1000mohand/Power-Monitor-Project/docs/Design.pdf

# هاى

# ßb¨aõaŒg

# دة كل اللى أنا أعرفه حالياً عن المشروع

فكرة المشروع مبنية على 3 حجات .1 لازم إننا نعرف الجهاز بيسحب كام أمبير عشان نعرف معدل إستخدام الطاقة خلال الشهر. لازم نعرف الجهاز شغال إمتى و مقفول إمتى و إمتى الإستهلاك بيزيد و إمتى الإستهلاك بيكون غير طبيعى. .2 يبقى فيه تحكم ذكى فى الجهاز يتقفل عن بعد, يتفح عن بعد, يقفل تلقائى فى حالة إستهلاك غير طبيعى. .3 الــESB و دة الميكروكنترولر اللى هيعمل الحسابات كلها و تتحكم فيه عن طريق الــWiFi.

الجزئ اللى أنا شغال عليه هو جزء قراية التيار و دة كل االى أنا وصلتله فى الجزء دة.

## 1 قراءة التيار

بص يا سيدى ديه الدايرةالكهربية اللى أنا كنت بفكر فيها بدل ما نشترى Sensor Current بــ٥٠جم. ممكن إننا نشيله و نحط حاجة بسيطة رخيصة بحيث إن الدايرةكلها ما تزيدش عن ٣٠جم. دةغير إنك حتى لو حطيت Sensor Current بــ٥٠جم. لسة هاتحتاج Amplifier Operational عشان تعرف تكبر الفروق الصغيرة اللى بتطلع من الــSensor. و فوق كل دة بعض أنواع الــSensor Current بيحتاج يتعاير محتاج أنه يتقارن بجهد مبدأى عشان تاخد منه قريات.

### 1 .1 الدايرة

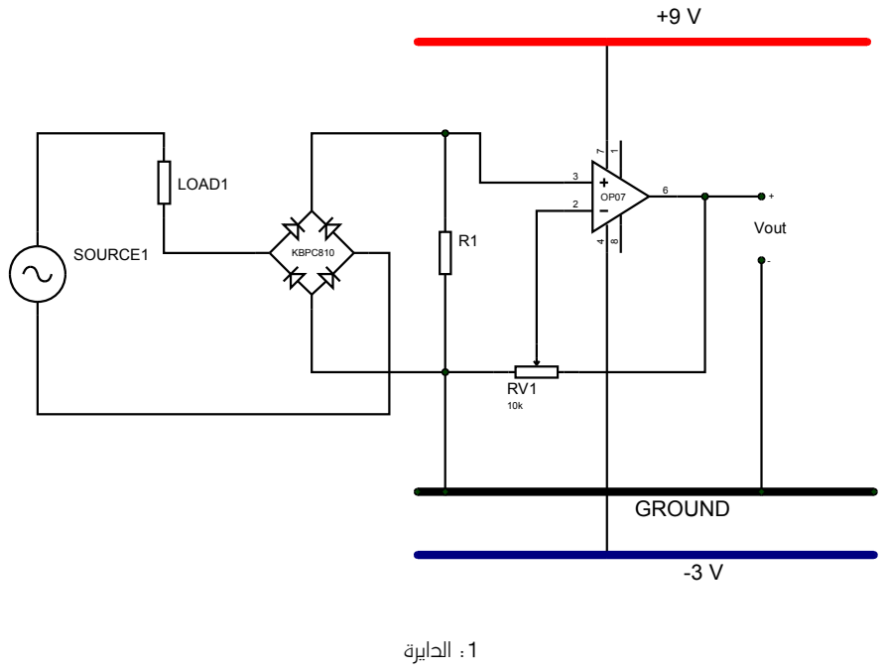
[picture p2: figure]
Vout; GROUND; SOURCE1; KBPC810; LOAD1; :1 الدايرة

بص يا سيدى:
ً أولا الــLOAD اللى انت شايفه هو والــSOURCE: دول بيمثله أى حاجة شغال (تكيف، عسالة، ماتور، اى حاجة...) و المتوصلة بالفيشة (اللى هى الــSOURCE طبعا).
ثانياً الحتة ديه ظريفة شوية، دة Rectifier شغلته أنه بيوحد إتجاه التيار اللى داخل على المقاومة الــ(Ω0.1(، و خلى بالك دة بيوحد التيار اللى داخل للمقاومة بس يعنى التيار و الجهد متغيرين عادى على الأحمال. ثالثاً هيييييـــــــح، التيار أياًكان إتجاهه على الــLOAD هايبفضل فى نفسالإتجاهعلى الــΩ،0.1 و دةعشان الــAMP OP يقرأ الڤولت اللى على المقاومة دايماَ فى نفس الإتجاه، الڤولت اللى على المقاومة بيبقا صغير و لذلك الــAMP OP بيكبره بشكل مناسب، ممكن إحنا نستغل دة بقا براحتنا بالتغير فى الريوستات 1RV بحيث إننا نظبط الڤولت بشكل يناسب الأردوينو أو الــESB. رابعاً مابين كل الأنواع بتاعة الــAmplifier Operational إحنا لازم نختار نوع يتعامل مع الڤولت الصغير بطريقة مناسبة. هتلاقى معظم الــAmplifiers Operational فيهم الــVolatge Offset¹ حوالى mV10–5 و دة كتير طبعا. النوع 07OP بقا دة الــOffset بتاعه
بيتقاس الــµV عشان كدة هو مناسب لينا. خامساً و أخيراً وديه بقا إسمها غباوة. بس دة اللى أنا عملته، النقط اللى متوصلة بالارضى كلها node واحدة هتبقى متوصلة بالأردوينو هنا بقى هتلاقى بعض متشددين الــsafety هايقولوا لو حصل fault ممكن يحصل مشاكل بس مصر كلها عايشة أهى قدامك و بقينا ١٠٠
مليون أو أكتر زى ما أنت شايف.☺ كان المفروض يبقا فيه Transformer Isolation ً مثلا أو أى حاجة ممكن تعمل Isolation بين الدايرتين(الــV220 AC و الــV12 DC (على سبيل المثال لو المقاومة Ω0.1 1R خرجت من الدايرة لأاى سبب أو أتحرقت الجهد اللى عليها

1الــVoltage Offset هو عبارة عن إزاحة صغيرة عن قيمة الجهد الداخل اللى بيكون عندها خرج الــ AMP OP V.0 شرحها على الموقع دة. (https://toshiba.semicon-storage.com/ap-en/semiconductor/knowledge/faq/linear_opamp/what-is-the-input-offset-voltage-of-an-op-amp.html)

هيبقى كبير جدا و أكيد هيبوظ الــAmplifier عشان كدة الدايرة ديه عايزة حرص كويس، وطالما إحنا إتعاملنا مع الدايرة كلها بحرص مش هيحص حاجة بإذن الله.

### 2 .1 حسبة الــGain

اللڤولت اللى على المقاومة 1R Ω1 صغير بيبقا بتاع V.1 اللڤولت دة مش مناسب أنه يتقرى على الــESB أو الأردوينو. الــAmplifier المفروض أنه يكبر الڤولت اللى على المقاومة 1R Ω1 عشان نعرف نحسب الــGain الصح بتاع الــAmplifier من الدايرة ممكن نتخيل إن الريوستات 1RV عبارة عن مقاومتين 2R 1,R.

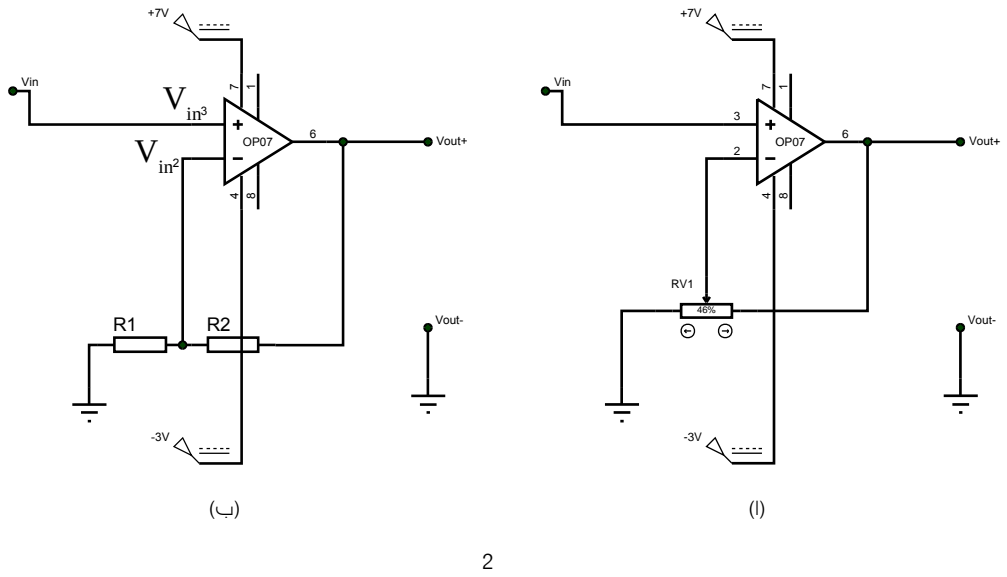
[picture p3: figure]
Vout-; Vin; Vout+

فى حالة إن الــAmplifier مثالى هيبقى 2Vin = 3Vin وعندنا

Vin² = Vout ×

R1
R1 + R2
يبقى

Vin³ = Vout ×

R1
R1 + R2
يعنى

Vout = Vin³ ×

R1 + R2
R1

= Vin ×

R1 + R2
R1

(1)

R1
يبقى إحنا ممكن نحدد قيمة الــgain بتاعنا عن طريق النسبة بين 2R1+R الــ07OP بيكبر من غير دايرة قيمة ضخمة جدا حوالى ٢٠٠ ألف مرة ضعف الجهد الداخل عشان كدة ممكن نعتبره قريب من أنه يكون مثالى، وعموما معظم أنواع الــAmplifier ليها معامل تكبير ضخم هو أنا جيبت الكلام دة من مكانين: الموقع دة (https://www.electronics-tutorials.ws/opamp/opamp_3.html) و الكتاب دة
المطلوب | الجزء | فيها | نسخة | هتلاقى | Behzad Razavi, Fundamentals of Microelectronics, Second Edition. page 357~359
مع الحاجة

### 3 .1 حساب نسبة التكبير من تيار الأحمال

إذا كانت مقاومة الأحمال هى RLOAD و الجهد الفعال (Volts 220 = VRMS (أى أن (Volts 311 ≈ Va = Vpeak(. يجب ظبط نسة التكبير لتحمل أقصى تيار لحظى أى (Va (بحيث عند هذا التيار يتولد أعلى جهد ممكن على دخل الــESB. أعلى جهد عند أعلى تيار يؤدى الى أعلى

دقة ممكنة. يكون الجهد المطبق على الأحمال أقل من VRMS بــ2 او 3 ڤولت نتيجة لوجود الــRectifier.

VLOAD = Va − Vdrop
| {z }

3 Volts
تضاف المقاومة Rsensor على التوالى مع الاحمال لقياس التيار. يمكن حساب التيار كالآتى

ILOAD =

Va − Vdrop

RLOAD + Rsensor
الجهد المتولد على المقاومة Rsensor هو الدخل للــAmplifier) Vsensor = Vin(. يجب أن يتم تكبيره ليصل الى أقصى جهد من خرج الــAmpilifer عند مرور أعلى تيار كالآتى:

Vout = Ga · Vin = Ga · ILOADRsensor

حيث Ga هو معامل التكبير. وإذا كان أقصى جهد لخرج الــAmplifier هو max Vout فإن:

Ga =

Vout

Vin

=

Vout max

Vsensor

=

Vout max

ILOADRsensor
من المعادلة 2 .1
R1 + R2
R1

= Ga

R1
R1 + R2

=

ILOADRsensor

Vout max

(2)

## 2 توزيعة الجهود و التغذية

عشاان نعرف نشغل الأجهز كل جهاز محتاج جهود مختلفة. .1 الــAmplifier محتاج جهد من V-3 لـV+9 عشان يشتغل. .2 الــ32ESP محتاجة V5 أو V.3.3 .3 طبعا الأرضى جهده V.0
هنستخدم طريقة بسيطة: أعلى جهد فى الدايرة هو الــV9 و أقل جهد هو V.-3 الفرق ما بينهم هو V.12 مش مهم حاجة فى الــsupply اللى هنستخدمه غير أنه يطلع فرق فى الجهود زى اللى إحنا عاوزينها. بمعنى إن لو الــsupply ً مثلا بيطلع V12 هيبقى أقل جهد فى الدايرة (الــV-3 (هو السالب بتاع الــsupply و الموجب هو الــV.9 كدة مظبوط الفرق بين أعلى جهد و أقل جهد فى الدايرة هو V.12 الجزئية اللى ّ بتلفف الدماغ الــGround فين؟ الــGround أعلى من الــV-3 بــV3 شيئ منطقى! الفكرة كلها أن الــGround دة نقطة فى الدايرة جهدها
ً | مفروض أنه بصفر عشان تقارن بقيت الجهود التانية بالنسبة ليه مش لأنه جهده فعلا بصفر. المهم دايما فى الدايرة عندك هو فرق الجهود. مثلا
فى الشكل 3 كل فروق الجهود ديه واحدة و كلهم نفس توزيعة الجهود و مناسبين لتشغيل الدايرة.

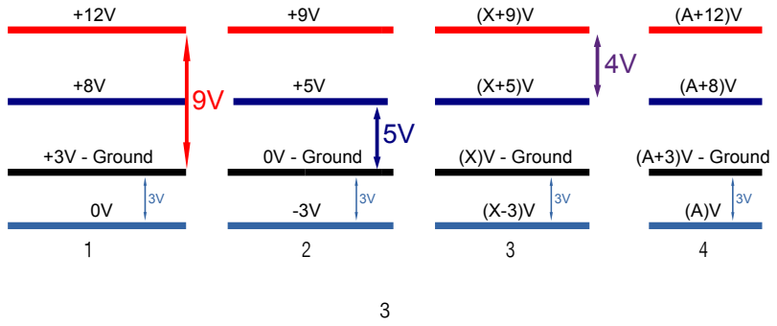
[picture p4: figure]
0V - Ground; (A+3)V - Ground; (X)V - Ground; +3V - Ground

طيب إحنا عرفنا نطلع أكبر جهد و أصغر جهد لكن الجهو اللى فى النصبتطلع إزاى؟ بــRegulator. بشكل عام فى نوعين من الــRegulator:

Positive Regulator •
ً | معروف بياخد طرفين فرق الجهد مابينهم كبير بيطلع حهد ثابت بالنسبة للجهد الصغير. مثلا V8 Regulator Voltage Positive لو
وصلته بــV12 و V،0 هتلاقى الــRegulator بيطلع V+8 بالنسبة للــV0 يعنى V-4 بالنسبة للــV12 زى اول شكل فى الصورة 3

Negative Regulator •
بيطلع جهد ثابت بالنسبة للجهد الكبير. بمعنى إن الــRegulator ً | بيطلع جهد أقل من أعلى جزء فى الدايرة بمقدار ثابت. مثلا لو عندنا V9
Regulator Voltage Negative لو وصلته بــV12 و V،0 هتلاقى الــRegulator بيطلع V-9 بالنسبة للــV12 يعنى V+3 بالنسبة للــV0 زى اول شكل فى الصورة 3 لاحظ إن معظم انواع الــRegulator بتوصل التيار فى إتجاه واحد بس الإتجاه التانى ممكن يحرقه. الــRegulator Positive بيخرج تيار فقط و الــRegulator Negative بيدخله تيار فقط. شرح أكتر فى المقال ده pdf.Regulator Voltage Linear هتلاقيه مع الملفات. عشان نعمل الدايرة كناه محتايجن توزيعة الجهود زى اللى فى الشكل .3 و عشان نعملها هنستخدم 2 Regulator Voltage. واحد V9 Regulator Negative يستخدم كــGROUND و يبقى الفرق بينه و بين الــV12 يبقى V.-9 اما التانى فهو Regulator Positive V5 هتركب من الــGround اللى إحنا عملنها لغاية الــV.12 و دة هيطلع جهد أعلى من الــGround بــV.5 دة بقا عشان يشغل الــESB. و بكدة تكون إكتمل التوزيعة و هيبقا شكلها حاجة شبه الدايرة اللى فالصورة ديه (صور 4)

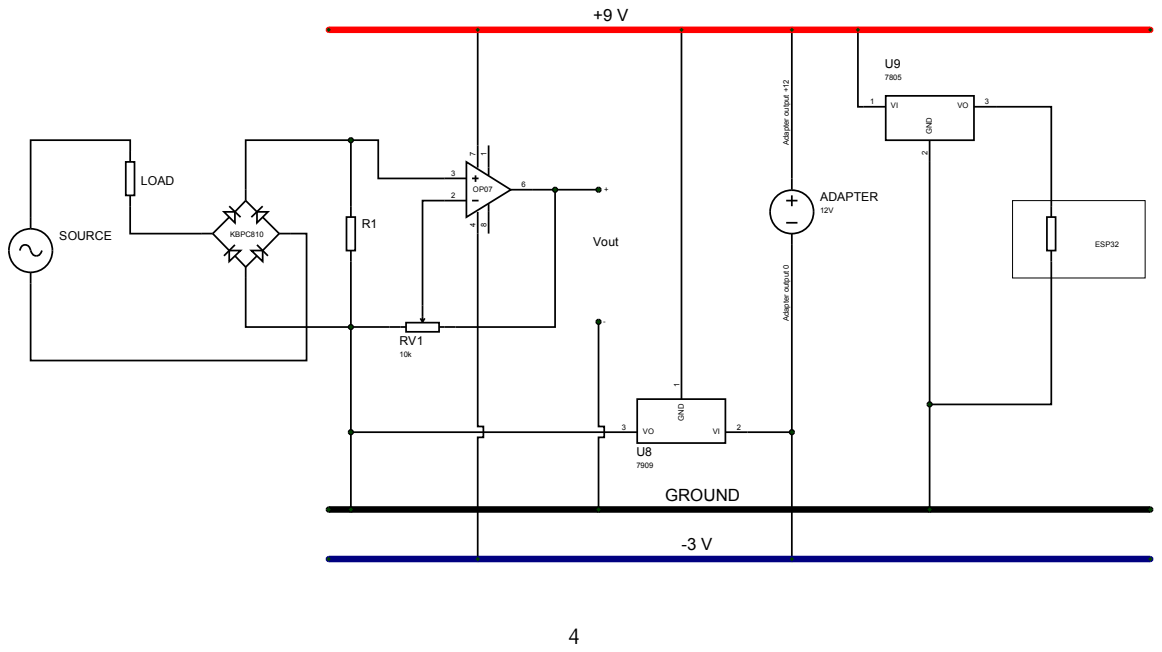
[picture p5: figure]
Adapter output 0; Adapter output +12; Vout; GROUND; SOURCE; KBPC810; LOAD; ADAPTER; GND; ESP32

فاضل حاجة واحد الــRegulator Voltage Negative بياخد الجهد العالى كــGround و الجهد القليل كــVinput.

Relay Switching Cricuit | 3
ً | عشان نشغل الريلاى و نقفله أولا محتاجين جهد V12 مش الــV3.3 بتوع الــESP. ثانياً تيار الريلاى كبير ما ينفعش يطلع من الــpins output
ESB. يبقا إحنا عوزين نخلى الدايرة تشغل الريلاى بجهد V.12 أكيد عشان نعمل كدة محتاجين ♥Transistor♥. الدايرة اللى أنا عرفت أعملها بتاخد 2 Transistor و شكل الدايرة فى الصور ديه (الصورة 5). هتلاقى فى الصورة الــSwitch بيعبر عن خرج الــESP. و الــ558BC دة PNP Transistor. الــ2222N2 دة NPN Transistor. أما الــV3.3 فدول إحنا هانجيبهم من الــESB نفسها. لو بصيت على الصورة 6 اللى فيها توزيع الــpinات هتلاقى من اول pin ديه بتبقا pin V.3.3

عشان نفهم الرسمة محتاجين مراجعة سريعة على الفرق بين الــPNP و الـNPN Transistor كــسويتشات. طيب NPN Transistor كان بيحتاج جهد الــbase يبقى أعلى من الــemitter عشان يوصل، لو الــbase اقل من الــemitter يبقى الــTransistor off cut و مش هيوصل، وكان الــcollector أعلى جهد فى الجهاز. أما PNP Transistor كان لازم الــbase يبقى أقل من الــemitter عشان يوصل، لو جهد base أعلى من الــemitter يبقى الــTransistor off cut و مش هيوصل، وكان الــcollector أقل جهد فى الجهاز.

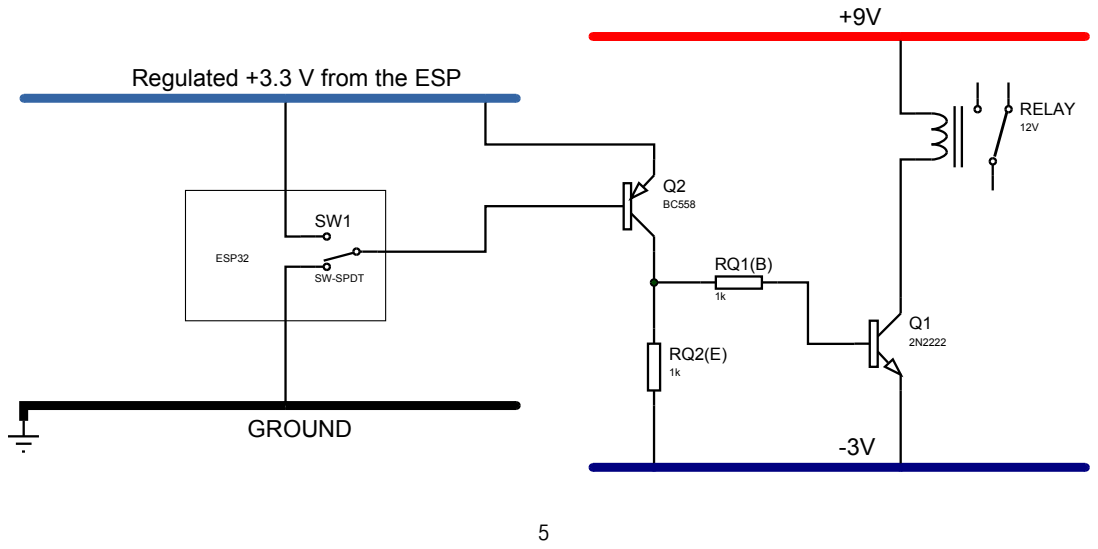
[picture p6: figure]
Regulated +3.3 V from the ESP; GROUND; ESP32; SW-SPDT; RELAY

كفاية كلام نخش على الشغل فى ملف إسمه "pdsprj.Circuit Switching "دة بقا هيفهمك الدايرة حلو بالــsimulation.

### The Mirco Controller (ESB) 4

هو فيه نوعين من الــESB: 32ESB و 8266ESP. إحنا هانحتاج الــ32ESB عشان هى اللى فيها pinات analog تناسب القرايات اللى بتطلع من الــAmpilifer. هو في موقع شارحهم كويسالموقع دة. (https://www.circuitspecialists.com/blog/esp-microcontroller-quick-start-guide/) لو بصيت علىصورةالــdiagram pin بتاعة الــ32ESBهتلاقى إن فيها pinات كتير لونها أخضرديه الــpinات اللى ممكن تشتغل analog. هى سعرها أغلى أنا عارف بس هى الأنسب لينا

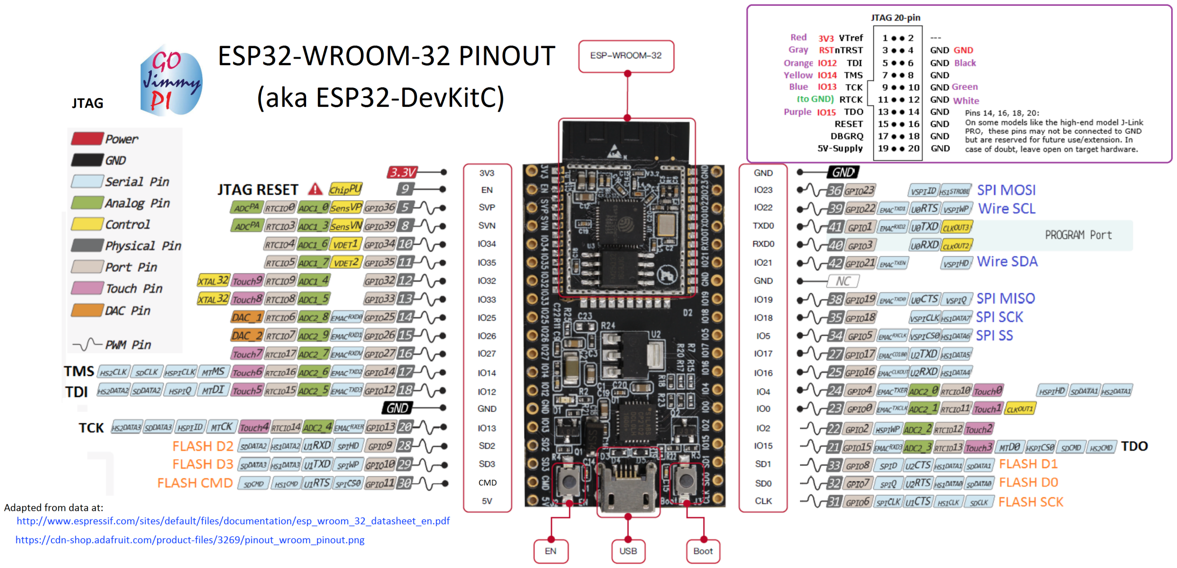
[picture p7: figure]

ESB32 Pin Diagram :6
هتلاقى الصورة ديه مع باقى الملفات

*ملحوظة هو فيه حل من غير الــ32ESB بس دة عاوز أنك تركب دايرة أو جهاز بعد الــAmpilifer عشان ينفع يتقرى بس طبعا دة أصعب من حيث الكود و من حيث الإنك تلاقى الجهاز أو الدايرة اللى ممكن تصمم بالشكل اللى أنت عاوزه

## 5 إضافة Capacitor لتنعيم القريات

بص يا كوكو عشان أنا زهقت و ما حدش كدة كدة بيقرأ البتاع دة. أولا إحنا حطينا الــCapacitor

R1

0.1

R2

1000

C1

LOAD CURRENT

7

قبل الــAmplifier عشان الـنحية التانية التيار محدود و فى نفس الوقت الــESB بيسحب تيار كبير شوية فهيطلع قرايات غلط، جربتها على Proteus. طيب ديه رسمة تقريب الجهد على الشمال. تلاحظ إن النسبة بين المقاومتين 1:10000 يعنى نسبة التيار اللى هيمشى فى المقاومة الكبيرة صغير جدا و بالتالى إحنا ممكن نقرب حسبة الجهد بإنه تيار الحمل فى المقاومة الصغيرة. عشان نبقا واخدين بالنا؛ تيار الــSource كبيرا أصلا فالتيار اللى هتسحبه مقاومة Ω1000 دة مش هيعمل مشاكل فى حدود التيار و فعلياً بمجرد ما المكثف يشحن التيار اللى بيمر بيبقا شبه معدوم. نخش بقا على الحسابات، هنا إحنا عاوزين التيار الجهد المتغير على المقاومة Ω0.1 1R يبقى جهد ثابت عشان كدة هنستخدم الــCapacitor كــ(LPF (Filter Pass Low هي ديه أصلا RC LPF منها نطلع إن الــFunction Transfer:

H(jω) = 1
1 + jωRC
يعنى نسبة التكبير اللى هتحصل فى الدايرة للجزء المتغيرهى:
H(jω)
=

1
p
1 + (ωRC)

2

=

1
p
(1 + (2fRC)

2
) شوية حسابات يطلع
H(jω)
لو إحنا عاوزين نمنع تردد Hz50 يبقا إحنا عاوزين مثلا يكون(2% =

RC ≥ 0.159 ΩF = 159 KΩμF
خلى بالك معنى إننا نخلى الــGain بــ2% دة معناه إن فيه نسبة خطأ 2% و دة بالنسبة للــWave Sin بس ديه أصلا Sin Rectified Wave بس عموما لما جربت على بروتس بتطلع النتايج قريبة جداً و فى نفس الوقت الخطأ أقل بشوية كسور. منطقى! بس هنا فيه شىء مهم ألا و هو إن الــinput عبارة عن إنصاص Wave Sin بتكرر 100مرة فى الثانية مش 50! ودة معنا إننا محتاجين الــFunction Transfer تبقا لــHz100 دة غير إن كدة كدة نسبة الخطأ بتبقا أصغر أصلا من المحسوبة فها نخليها 3% بدل 2% نطلع بقا بشكل المعادلة:
H(jω)
=

1
r
(1 + (2 × 100
|{z}

f requency

×RC)
2

يعنى :
RC ≥ 0.053 ΩF = 53 KΩμF
تلاحظ كدة إننا ممكن نستخدم RC قيمتها أقل و دة يققل من قيمة الكثف اللى إنا محتاجين نجيبه. بالنسبة للــResponse Time هنا بقا الموضوع يختلف هنا المطلوب هو إننا نعرف فى حالة تغير فى التيار المكثف هياخد وقت قد إيه (يشحن
أو يفرغ) عشان التغير دة يتقرى. طريقة بسيطة نقرب بيها العملية هى الــResponse Step للــCircuit RC المعادلة ديه –جدعنة من عندى كدة أنا اللى جايبها– بتعبر عن العلاقة بين الــResponse و Time للدايرة

R(t) = 1 − e

(t/τ) = e

(t/R·C)
(step response equation)
يبقا لو ΩF0.053 = RC هيطلع إن عشان المكثف يوصل لــ98% من قيمة التيار الحقيقية هياخد mS .207 الحقيقة إنا دة بيفرض إن الــinput عبارة عن Response Step لكن الأصل إن الــinput عبارة عن Wave Sin Rectified الوقت بيبقى أطول بحوالى +25% من الوقت الأصلى لما جربتها على Proteus طيب لو دورت على RAM هتلاقى إن المكثف المتاح μF100 و أنسب مقاومة تجاب هى Ω1000 نحسب بقا من جديد الــ 0.1 = RC أكبر من المحسوبة بس لسة أصغر من الــHz50 و إيه هى القيمة الجديد لمعامل لتكبير الــinput المتغير:
H(hω)
=

1
p
(1 + (2 × 100 × 0.1)²

= 0.0159134789711477

طبعا زى ما هو واضح من الأرقام مكثف سعة أكبر = تنعيم أكتر للإشارة. طيب بس هنا الــResponse Time هيبقى أبطأ من معادلة
Step Response Timeالــ | إن | يطلع | Step Responseالــ

T = 0.3912 (S)
طبعا محتاجين ناخد رقم أكبر من دة عشان الوقت الفعلى بيكون أكبر وليكن S0.5 هنا بقا الدايرة هتبقى كالآتى

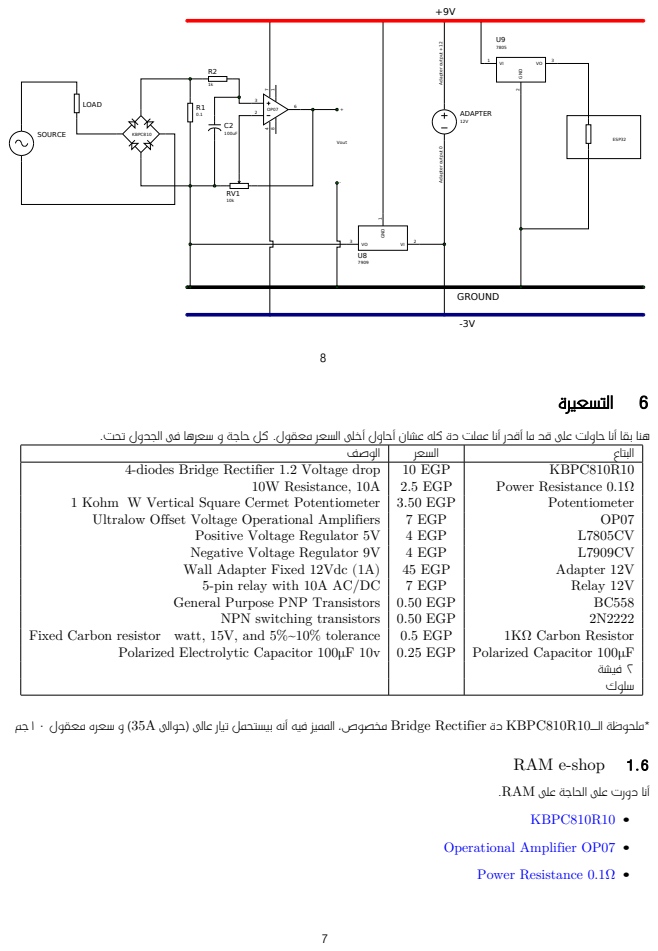
[picture p8: page 8]
GROUND; SOURCE; KBPC810; LOAD; ADAPTER; GND; ESP32; Vout; 6 التسعيرة; KBPC810R10 •; Operational Amplifier OP07 •; Power Resistance 0.1Ω •

Adapter output 0 Adapter output +12

هنا بقا أنا حاولت على قد ما أقدر أنا عملت دة كله عشان أحاول أخلى السعر معقول. كل حاجة و سعرها فى الجدول تحت.

البتاع السعر الوصف

4-diodes Bridge Rectifier 1.2 Voltage drop 10W Resistance, 10A 1 Kohm W Vertical Square Cermet Potentiometer Ultralow Offset Voltage Operational Amplifiers Positive Voltage Regulator 5V Negative Voltage Regulator 9V Wall Adapter Fixed 12Vdc (1A) 5-pin relay with 10A AC/DC General Purpose PNP Transistors NPN switching transistors Fixed Carbon resistor  watt, 15V, and 5%~10% tolerance Polarized Electrolytic Capacitor 100μF 10v | 10 EGP 2.5 EGP 3.50 EGP 7 EGP 4 EGP 4 EGP 45 EGP 7 EGP 0.50 EGP 0.50 EGP 0.5 EGP 0.25 EGP | KBPC810R10 Power Resistance 0.1Ω Potentiometer OP07 L7805CV L7909CV Adapter 12V Relay 12V BC558 2N2222 1KΩ Carbon Resistor Polarized Capacitor 100μF ٢ فيشة سلوك

*ملحوظة الــ10R810KBPC دة Rectifier Bridge مخصوص، المميز فيه أنه بيستحمل تيار عالى (حوالى A35 (و سعره معقول ١٠جم

RAM e-shop 1 .6
أنا دورت على الحاجة على RAM.

Potentiometer 1KΩ (https://ram-e-shop.com/product/pot-th-1k/) •

L7805CV (https://ram-e-shop.com/product/7805-china/) •

L7909CV (https://ram-e-shop.com/product/7909/) •

Adapter 12V (https://ram-e-shop.com/product/adaptor-fixed-12v-1a/) •

Relay 12V (https://ram-e-shop.com/product/re1/) •

BC558 (https://ram-e-shop.com/product/bc558/) •

2N2222 (https://ram-e-shop.com/product/2n2222/) •

1KΩ Carbon Resistor (https://ram-e-shop.com/product/fixed-resistances-63/) •

Polarized Capacitor 100μF (https://ram-e-shop.com/product/c-100u10v/) •

o¸
