1000mohand/Power-Monitor-Project/docs/smothing cap current and voltage approx .pdf

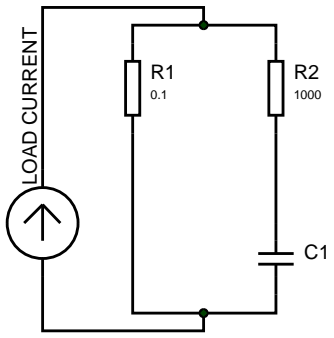
[picture p9: figure]
LOAD CURRENT
