1000mohand/Power-Monitor-Project/docs/vref.pdf

+8V | +5V | (X+5)V | (A+8)V
| 0V - Ground | | (A+12)V

(A+3)V - Ground

(X+9)V

(X)V - Ground

-3V | (X-3)V | (A)V

+9V

0V

+3V - Ground

+12V

9V
5V

4V

3V | 3V | 3V | 3V
1 | 2 | 3 | 4
