1000mohand/Power-Monitor-Project/docs/op amp cut.pdf

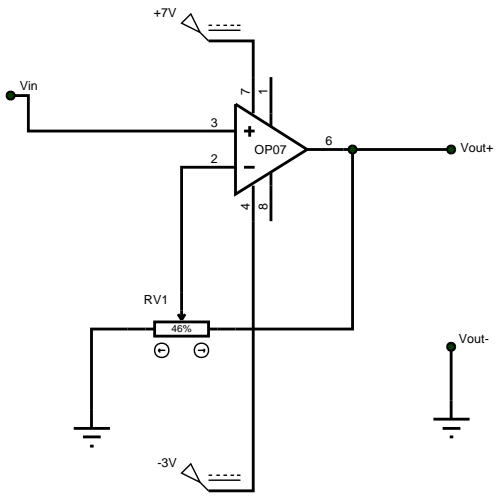
[picture p10: figure]
Vout-; Vout+; Vin
