1000mohand/Power-Monitor-Project/docs/proteus_current_sensor.png

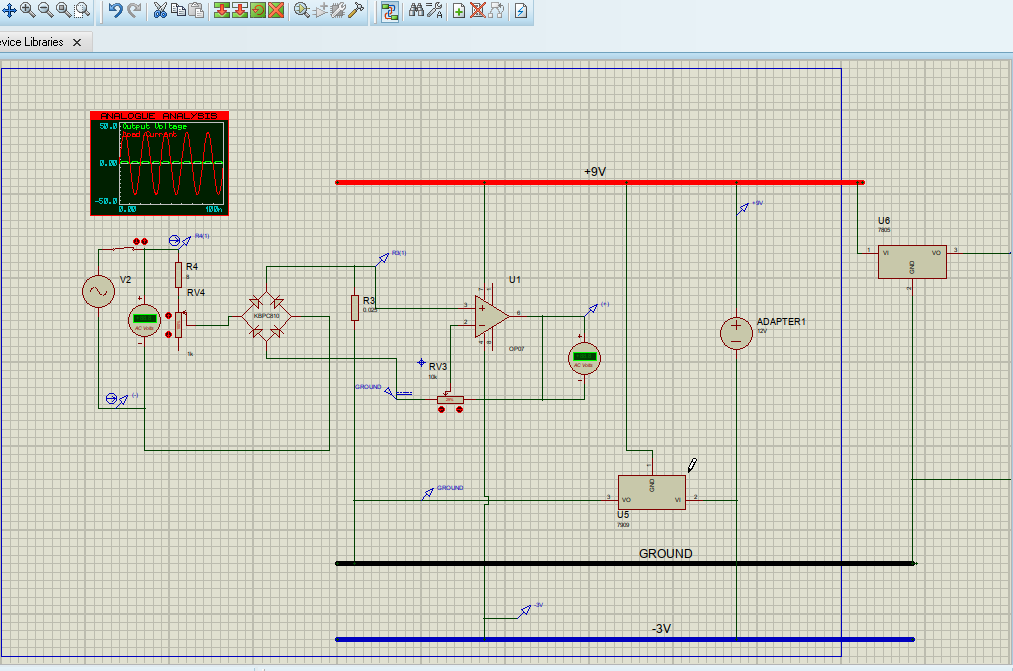
docs/proteus_current_sensor.png
