1000mohand/Power-Monitor-Project/docs/MinGw Setup Instruction.pdf

# تسطيب MinGw

# âï¼‹Üaçb¼‹ÜaBaâi

## 1 مقدمة ما لهاش لازمة

MinGw دة هنستخدمه عشان نعرف نجرب كود و إحنا شغالين النهاردة. لأننا النهاردة كل اللى هنعمله إننا هنجرب شوية أكواد لغاية ما يبقا عندنا فكرة حلوة عن الــ++c.

## 2 المهم

.1 هتفتح الموقع بتاع تحميل الــMinGw https://osdn.net/projects/mingw/releases/ وتحمل التسطيب زى كدة

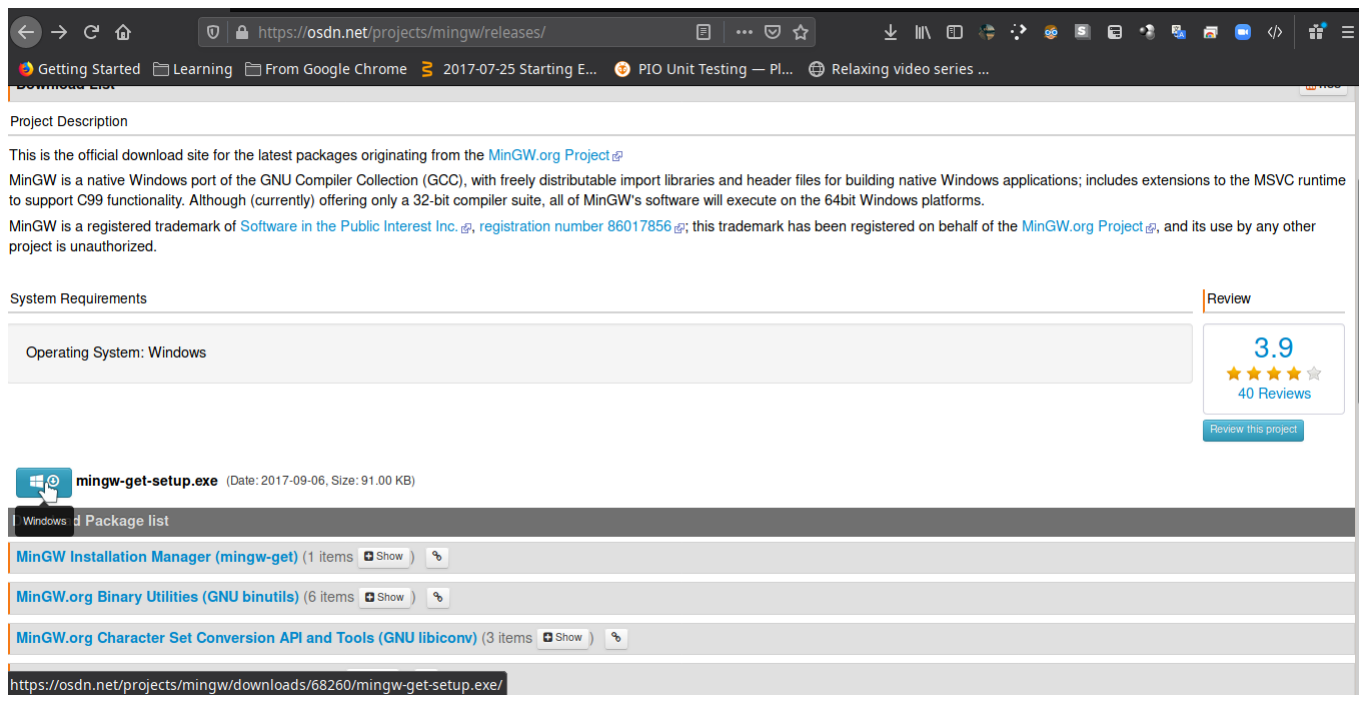
[picture p12: figure]

.2 بعد ماتحمله هتسطبة زى كدة

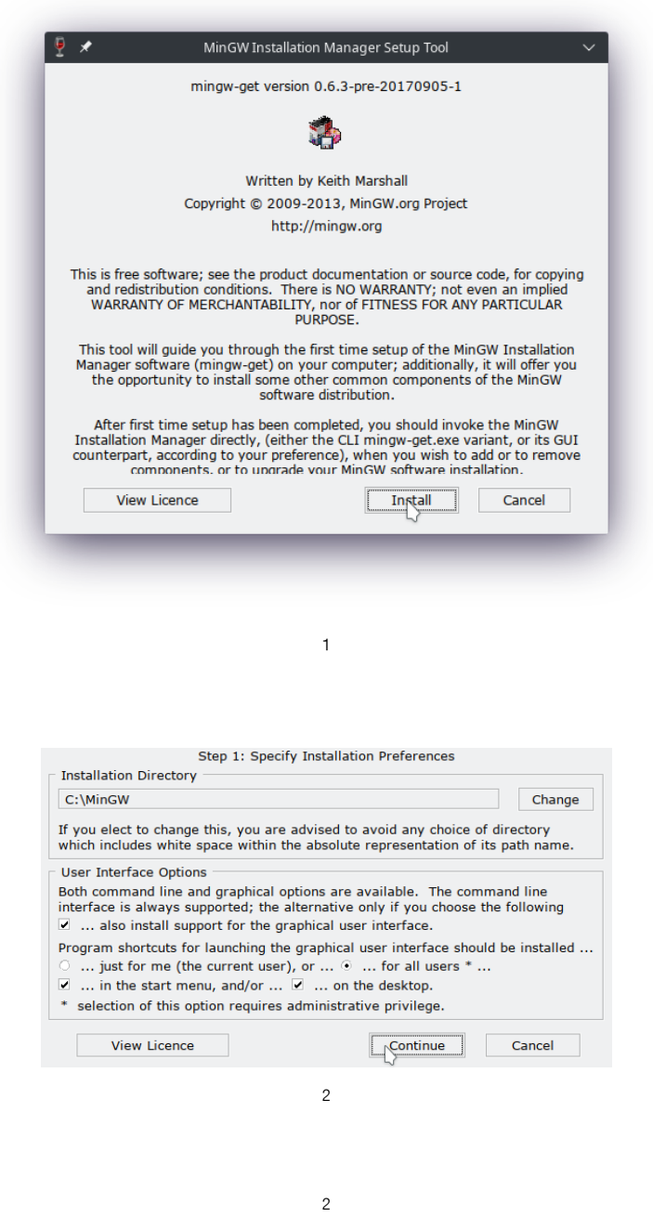
[picture p13: page 3]

122

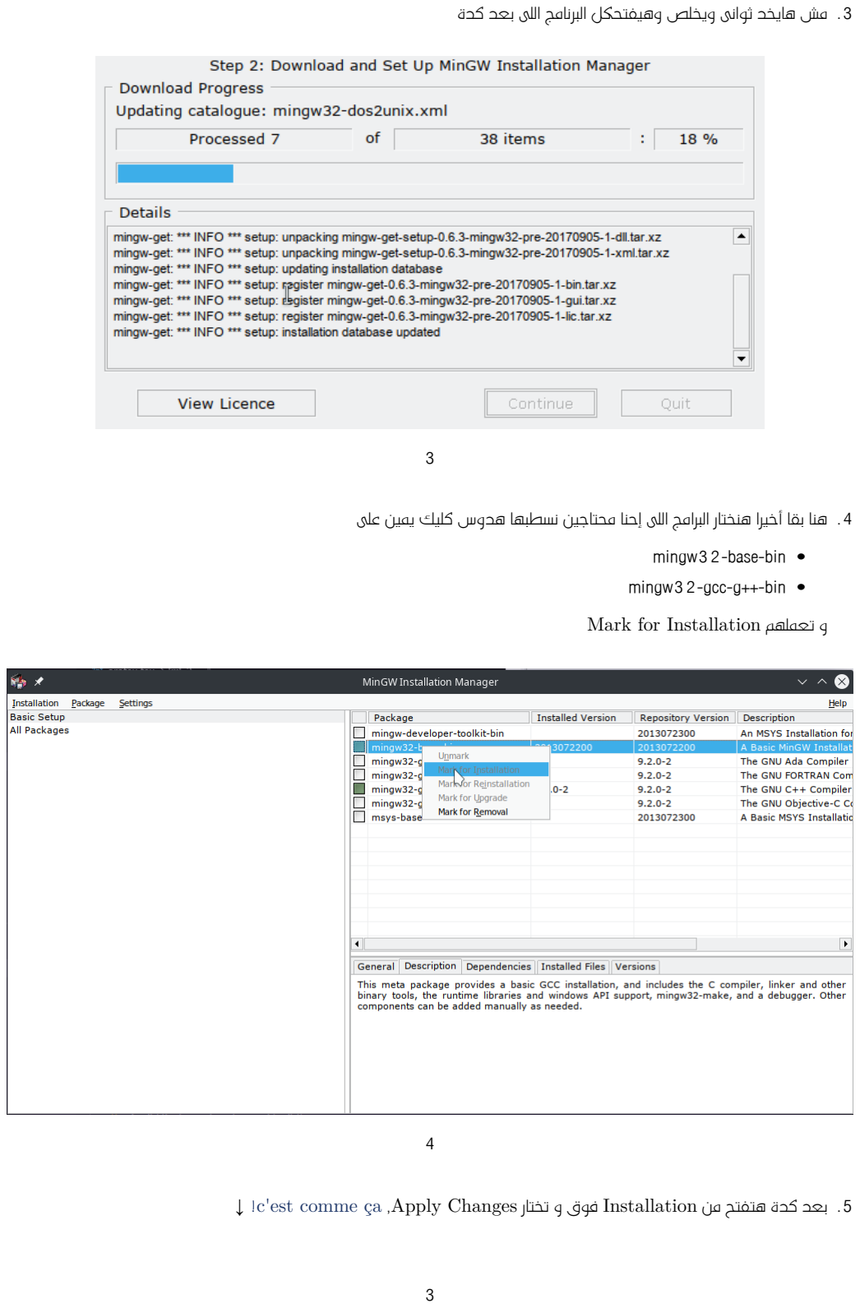
[picture p14: page 4]

.3 مش هايخد ثوانى ويخلص وهيفتحكل البرنامج اللى بعد كدة

3

.4 هنا بقا أخيرا هنختار البرامج اللى إحنا محتاجين نسطبها هدوس كليك يمين على mingw32‐base‐bin •
mingw32‐gcc‐g++‐bin •
Mark for Installation | تعملهم | و

4

.5 بعد كدة هتفتح من Installation فوق و تختار Changes Apply, ça comme est'c↓ !

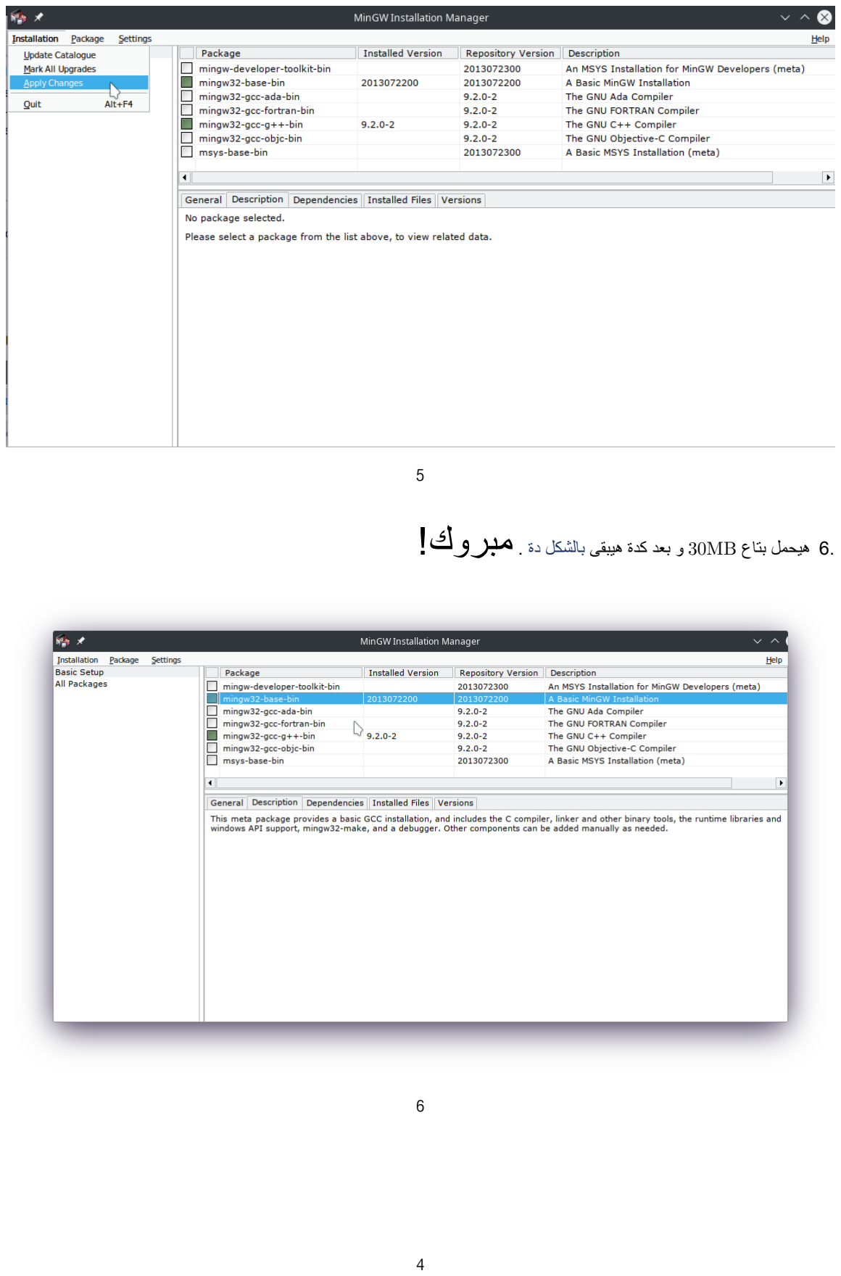
[picture p15: page 5]

5

6. هيحمل بتاع MB30 و بعد كدة هيبقى بالشكل دة .مبروك!

6
