1000mohand/Power-Monitor-Project/docs/DIYCS with smothing cap.pdf

U9

+9V

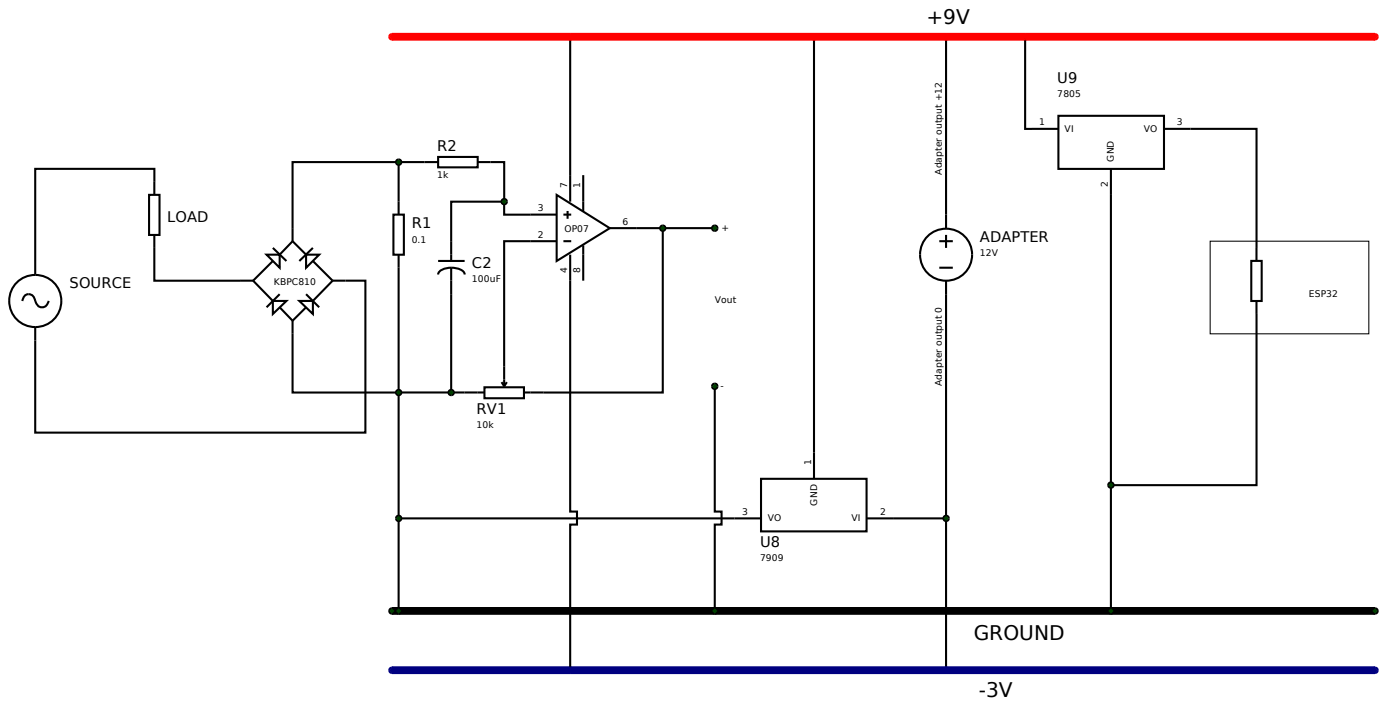
[picture p16: page 1]
GROUND; SOURCE; KBPC810; LOAD; ADAPTER; GND 1; GND 2; ESP32; Vout

Adapter output 0 Adapter output +12
