1000mohand/Power-Monitor-Project/docs/DIYCS.pdf

+9 V

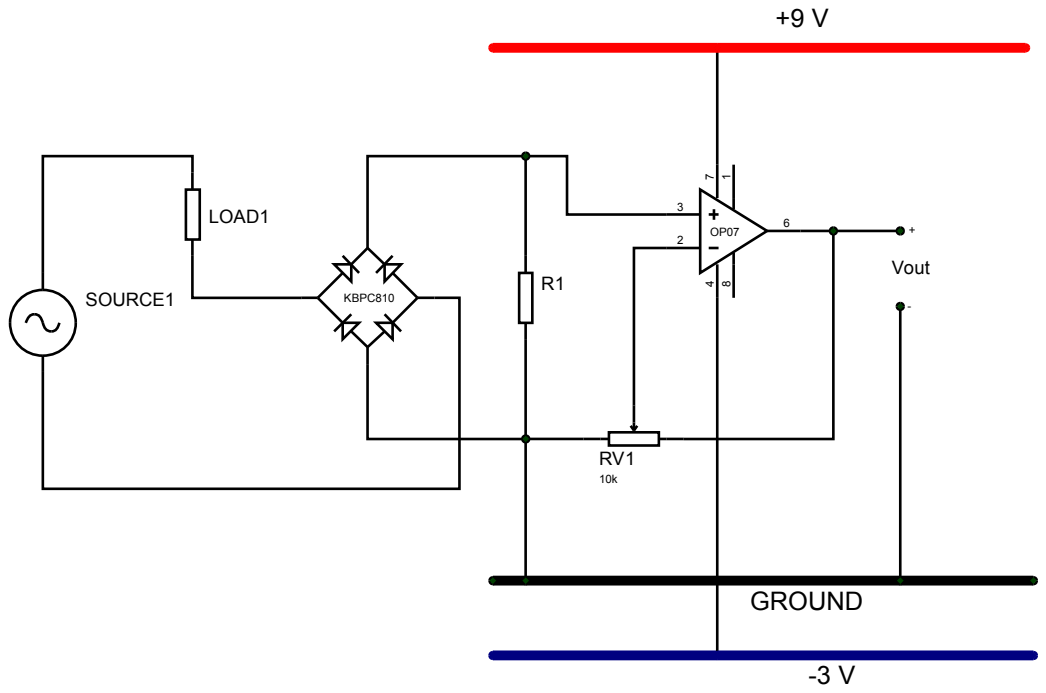
[picture p17: page 1]
Vout; GROUND; SOURCE1; KBPC810; LOAD1
