1000mohand/Power-Monitor-Project/docs/DIYCS_Supply.pdf

+9 V

U9

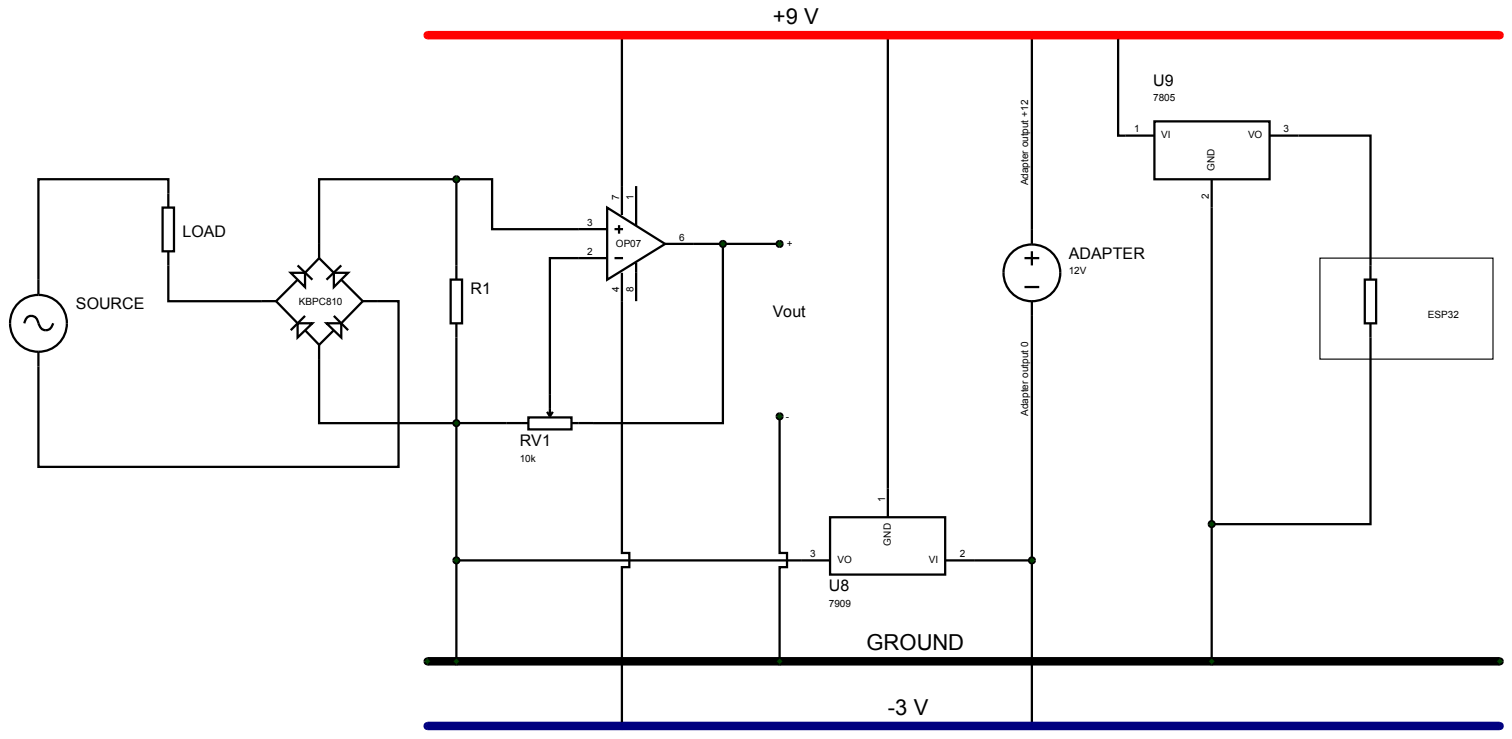
[picture p18: page 1]
Adapter output 0; Adapter output +12; Vout ⁺-; GROUND; SOURCE; KBPC810; LOAD; ADAPTER; GND 1; GND 2; ESP32
