1000mohand/Power-Monitor-Project/docs/Switching Circuit.pdf

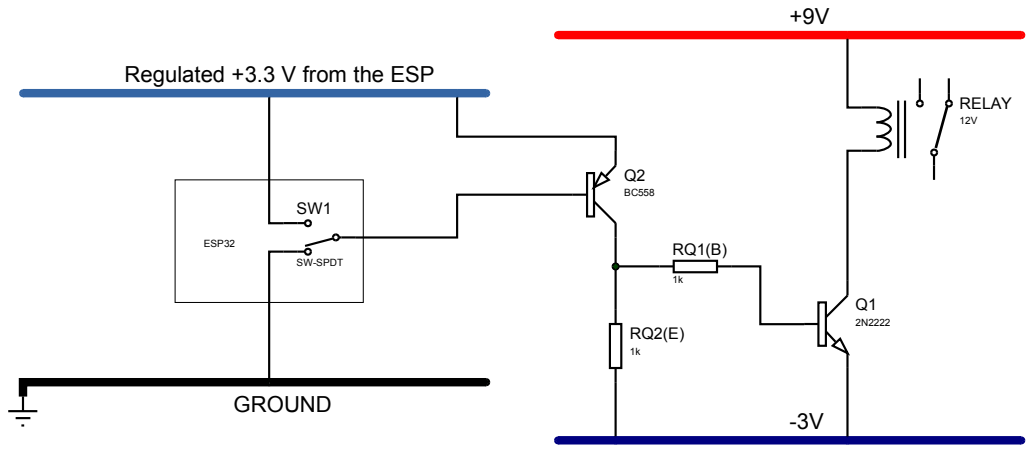
[picture p19: page 1]
GROUND; ESP32; SW-SPDT; RELAY

Regulated +3.3 V from the ESP
