1000mohand/Power-Monitor-Project/docs/op amp cut exp.pdf

## Vin

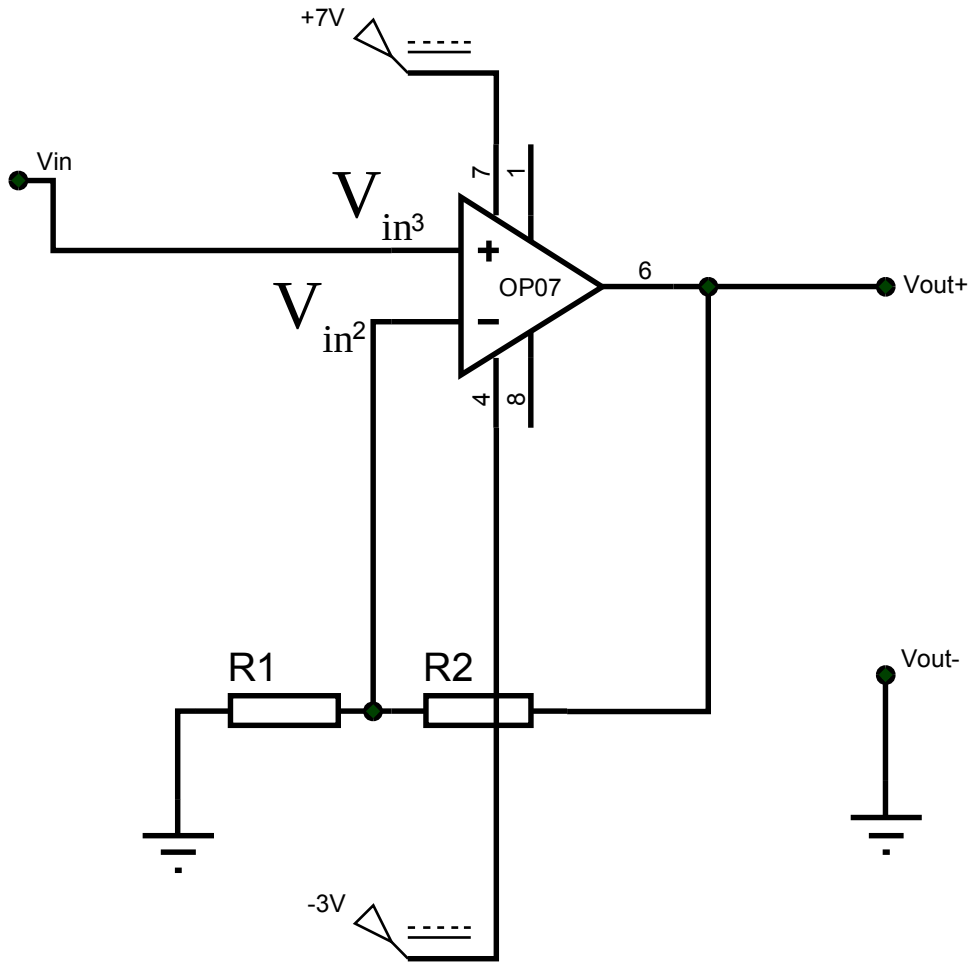
[picture p20: page 1]
Vout-; Vin; Vout+
