1000mohand/Power-Monitor-Project/(list of files, drawings)

Other design files:
Proteus/Capacitor Smothing.pdsprj
Proteus/Project Circuits.pdsprj
Proteus/Switching Circuit.pdsprj
Proteus/Voltage Ref.pdsprj
